NCKiser/Aioli/README.md

# Aioli
3x3 Macropad with 9 Encoders or MX Switches

GPL 2, Open Source, Please credit [Noah Kiser, KiserDesigns.com]
