NCKiser/Aioli/PCB/Aioli/Case v7.png

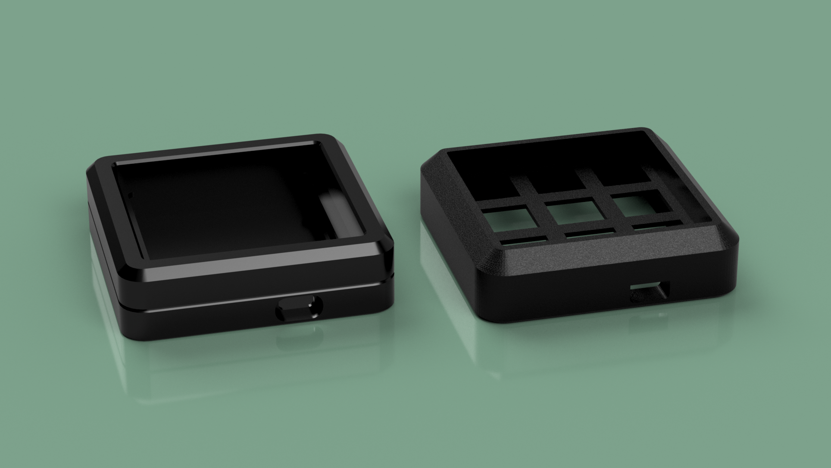
PCB/Aioli/Case v7.png
