NCKiser/Aioli/PCB/Aioli/Aioli.step

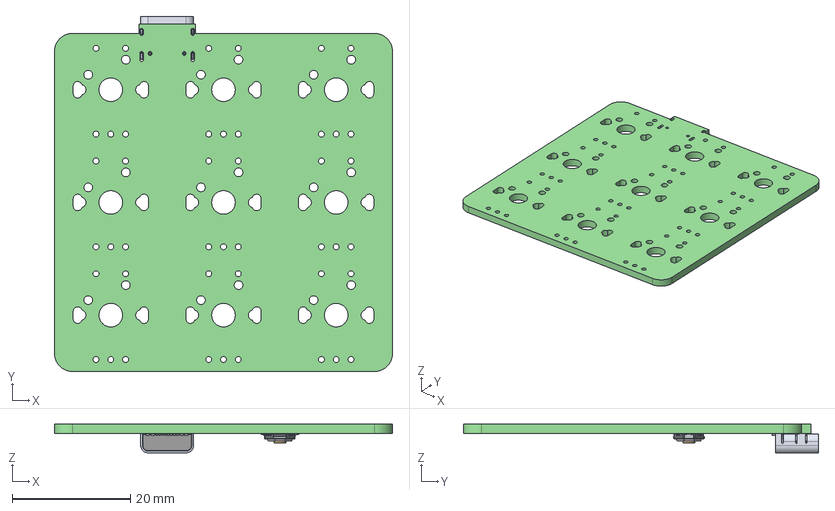
[picture p2: CAD file, 2022-03-29]
PCB/Aioli/Aioli.step
57.1 x 60.0 x 4.86 mm
Aioli PCB
