NCKiser/Aioli/Switch Plate.3mf

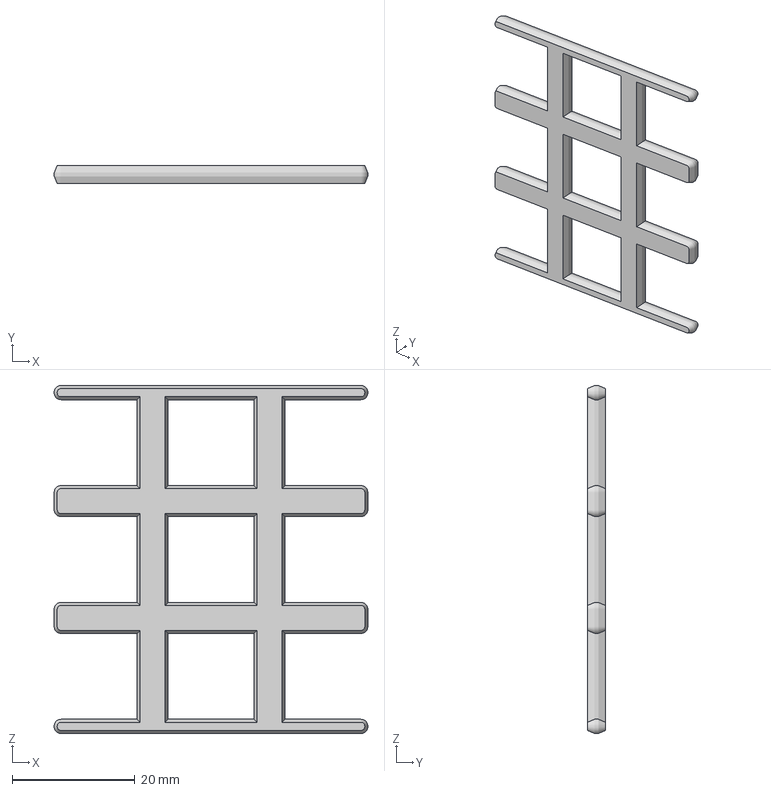
[picture p3: CAD file, 2022-03-29]
Switch Plate.3mf
51.1 x 3.00 x 56.8 mm
