NCKiser/Aioli/Case Bottom v3.3mf

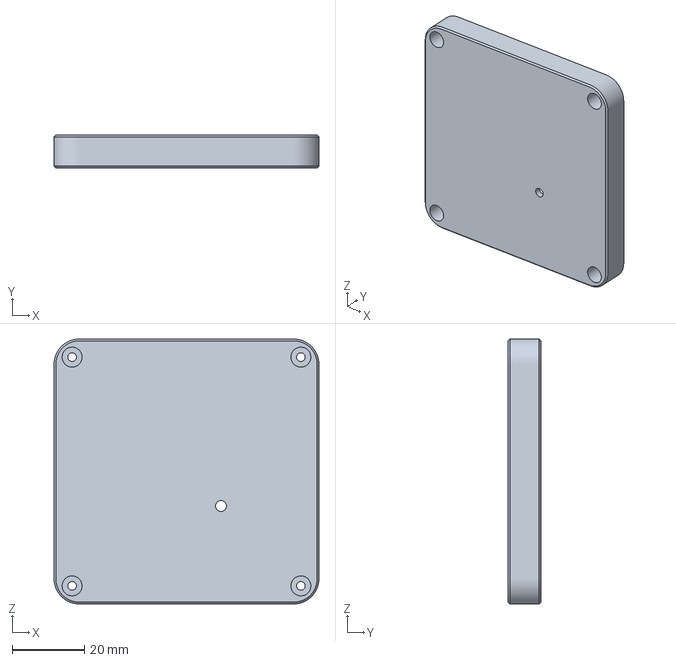
[picture p4: CAD file, 2022-03-29]
Case Bottom v3.3mf
73.2 x 9.10 x 73.2 mm
