NCKiser/Aioli/Case Top v3.3mf

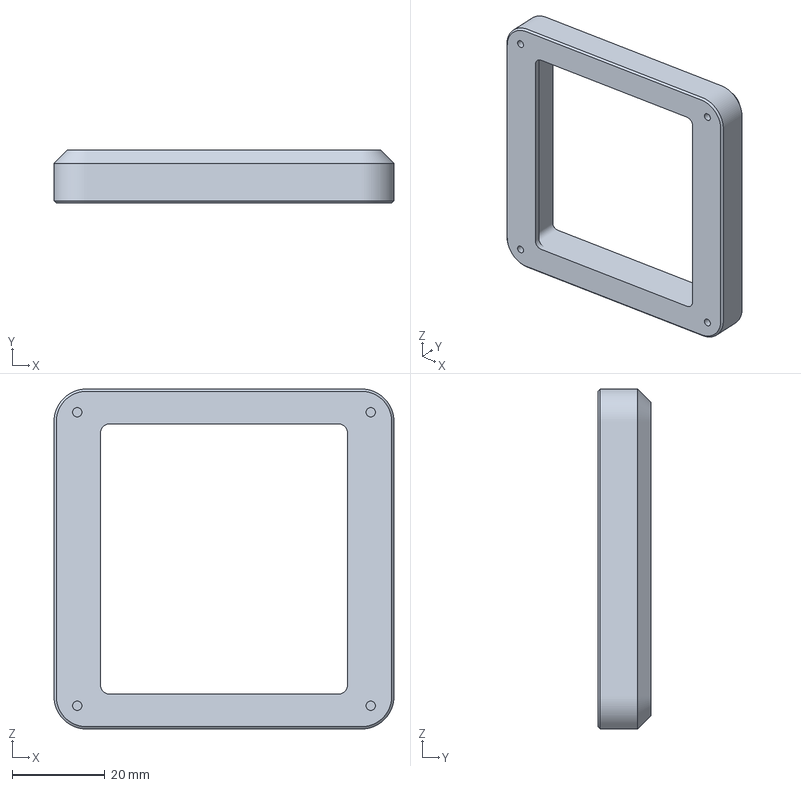
[picture p5: CAD file, 2022-03-29]
Case Top v3.3mf
73.2 x 11.5 x 73.2 mm
