NCKiser/Aioli/Aioli PCB.3mf

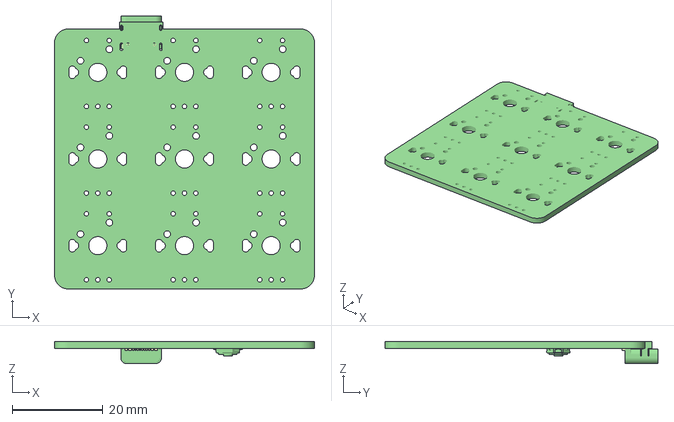
[picture p6: CAD file, 2022-03-29]
Aioli PCB.3mf
57.1 x 60.0 x 4.86 mm
