NCKiser/Aioli/Case Top v2.3mf

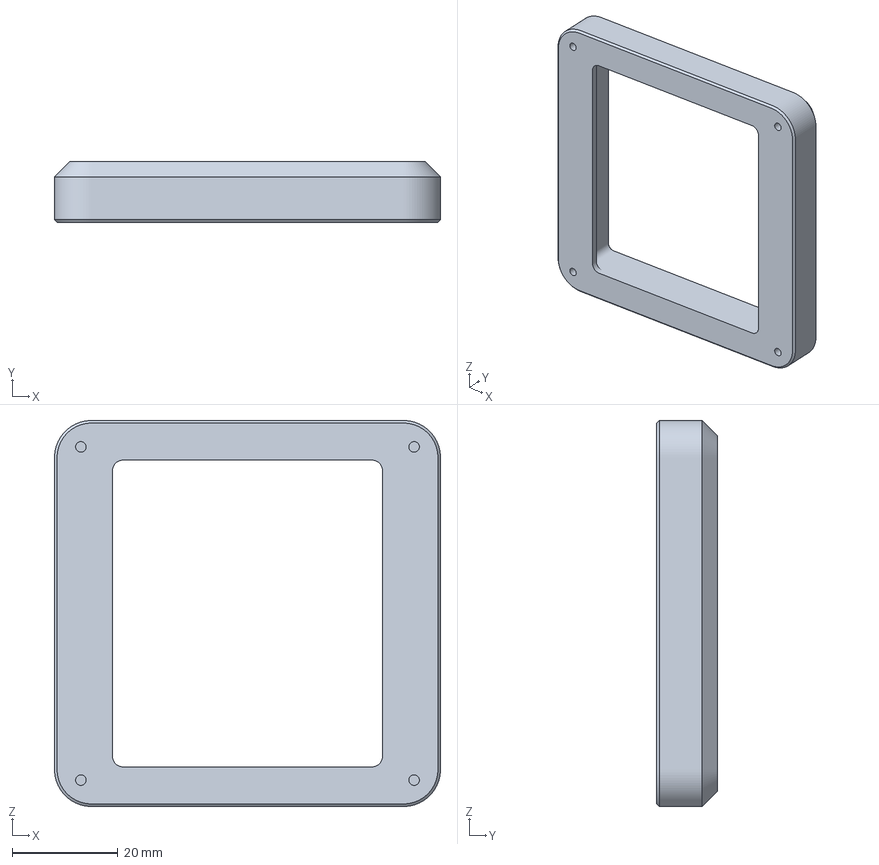
[picture p7: CAD file, 2022-03-29, an earlier design]
Case Top v2.3mf
73.2 x 11.5 x 73.2 mm
