NCKiser/Aioli/(list of files, cad)

Other CAD files:
Aioli Bottom.step
Aioli Top.step
Case Bottom v1.3mf
Case Bottom v2.3mf
Aioli Case.f3z
Case v18.f3z
