NCKiser/Aioli/Aioli Bottom.pdf

# 9.10 ⁰.5mm champer/deburr

73.15 | 52.15 | 58.15 | 73.15 Ø3.00

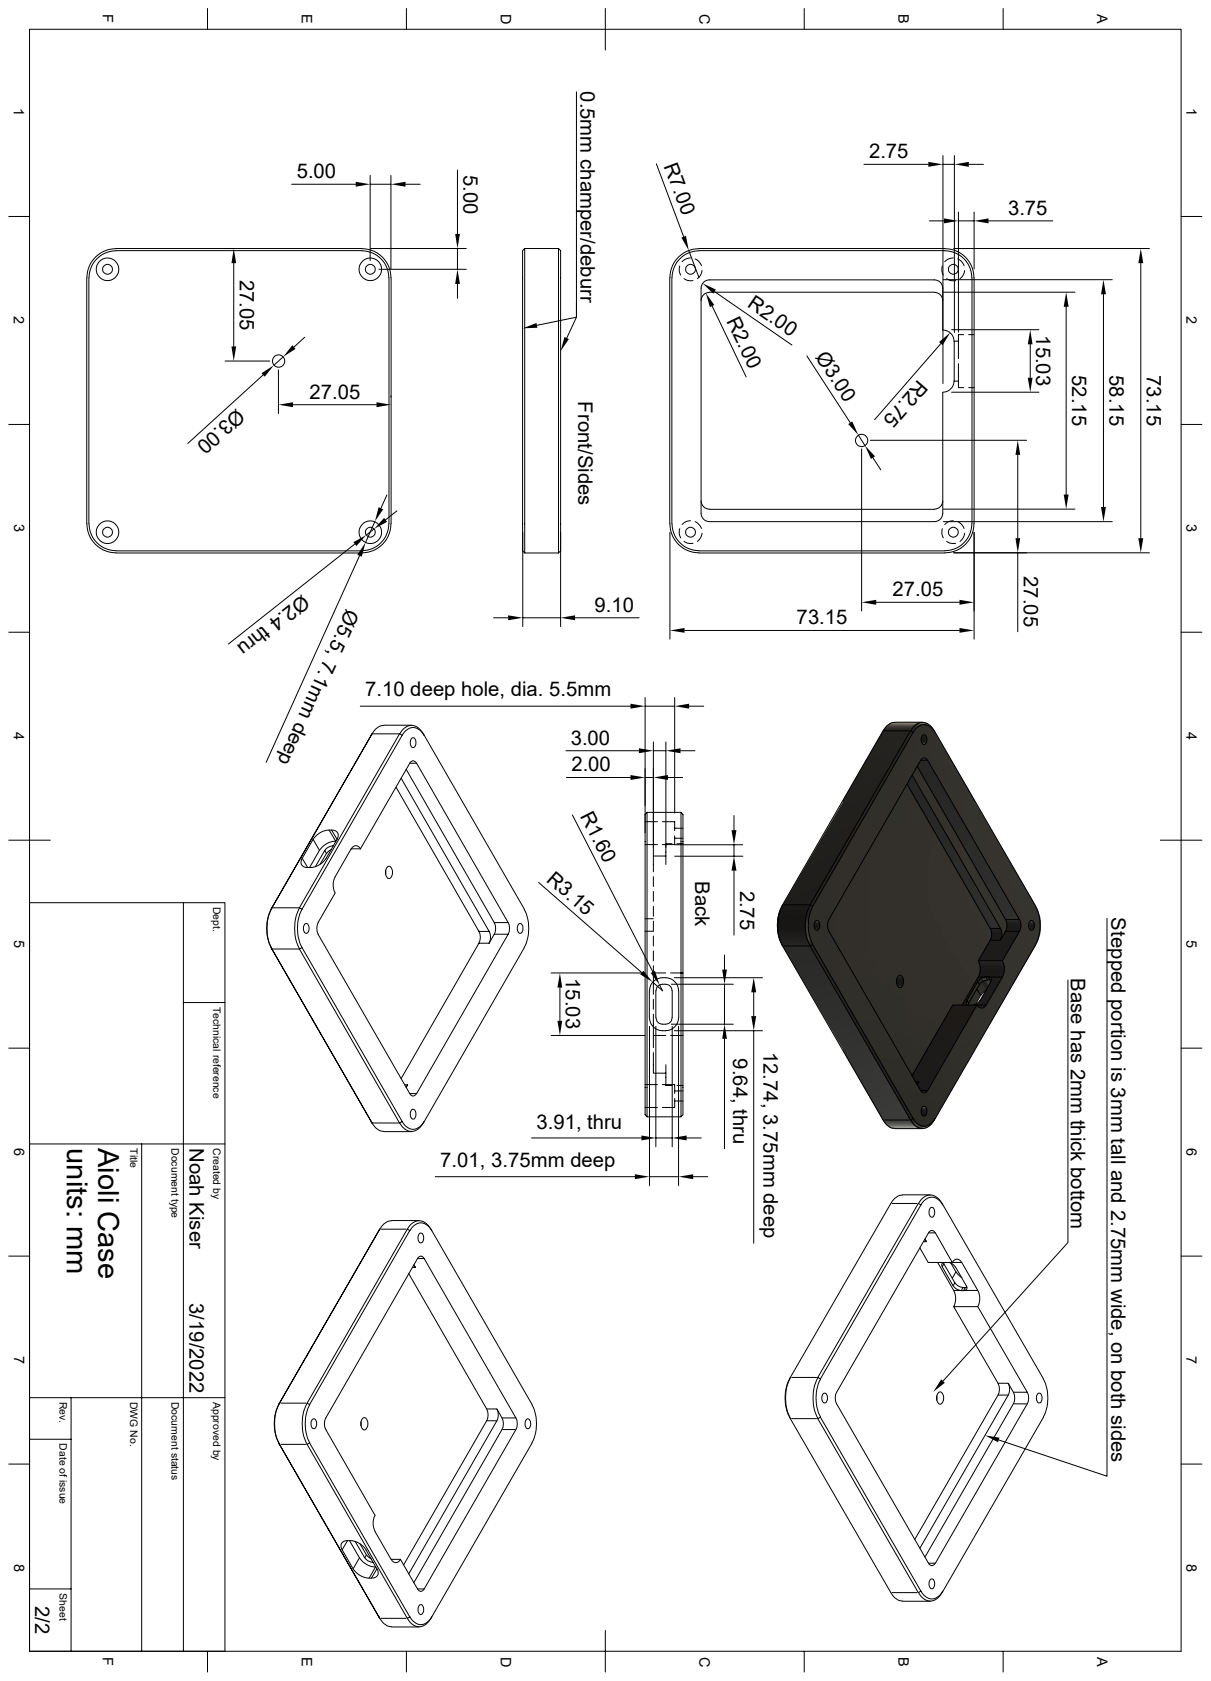
[picture p8: page 1]
2.75 15.03 R2.00 R2.00 R7.00 Front/Sides; Ø5.5, 7.1mm deep Ø2.4 thru; 7.10 deep hole, dia. 5.5mm 15.03; 12.74, 3.75mm deep 9.64, thru3.91, thru; 7.01, 3.75mm deep; Back; Stepped portion is 3mm tall and 2.75mm wide, on both sides Base has 2mm thick bottom

1 A 2 3 4 5 6 7 8 1 2 3 4 5 6 7 8 FEDCB FEDCBA Dept. Technical reference Created by Approved by Title DWG No. Document type Document status Rev. Date of issue Sheet 3/19/2022 2/2 units: mm Aioli Case Noah Kiser
