NCKiser/Aioli/Aioli Top.pdf

5.00 | 5.00 | R1.60 | R2.00 | R7.00 | R4 1.
2.9 2.9 0.5mm chamfer/deburr | 0.75mm inner chamfer/deburr

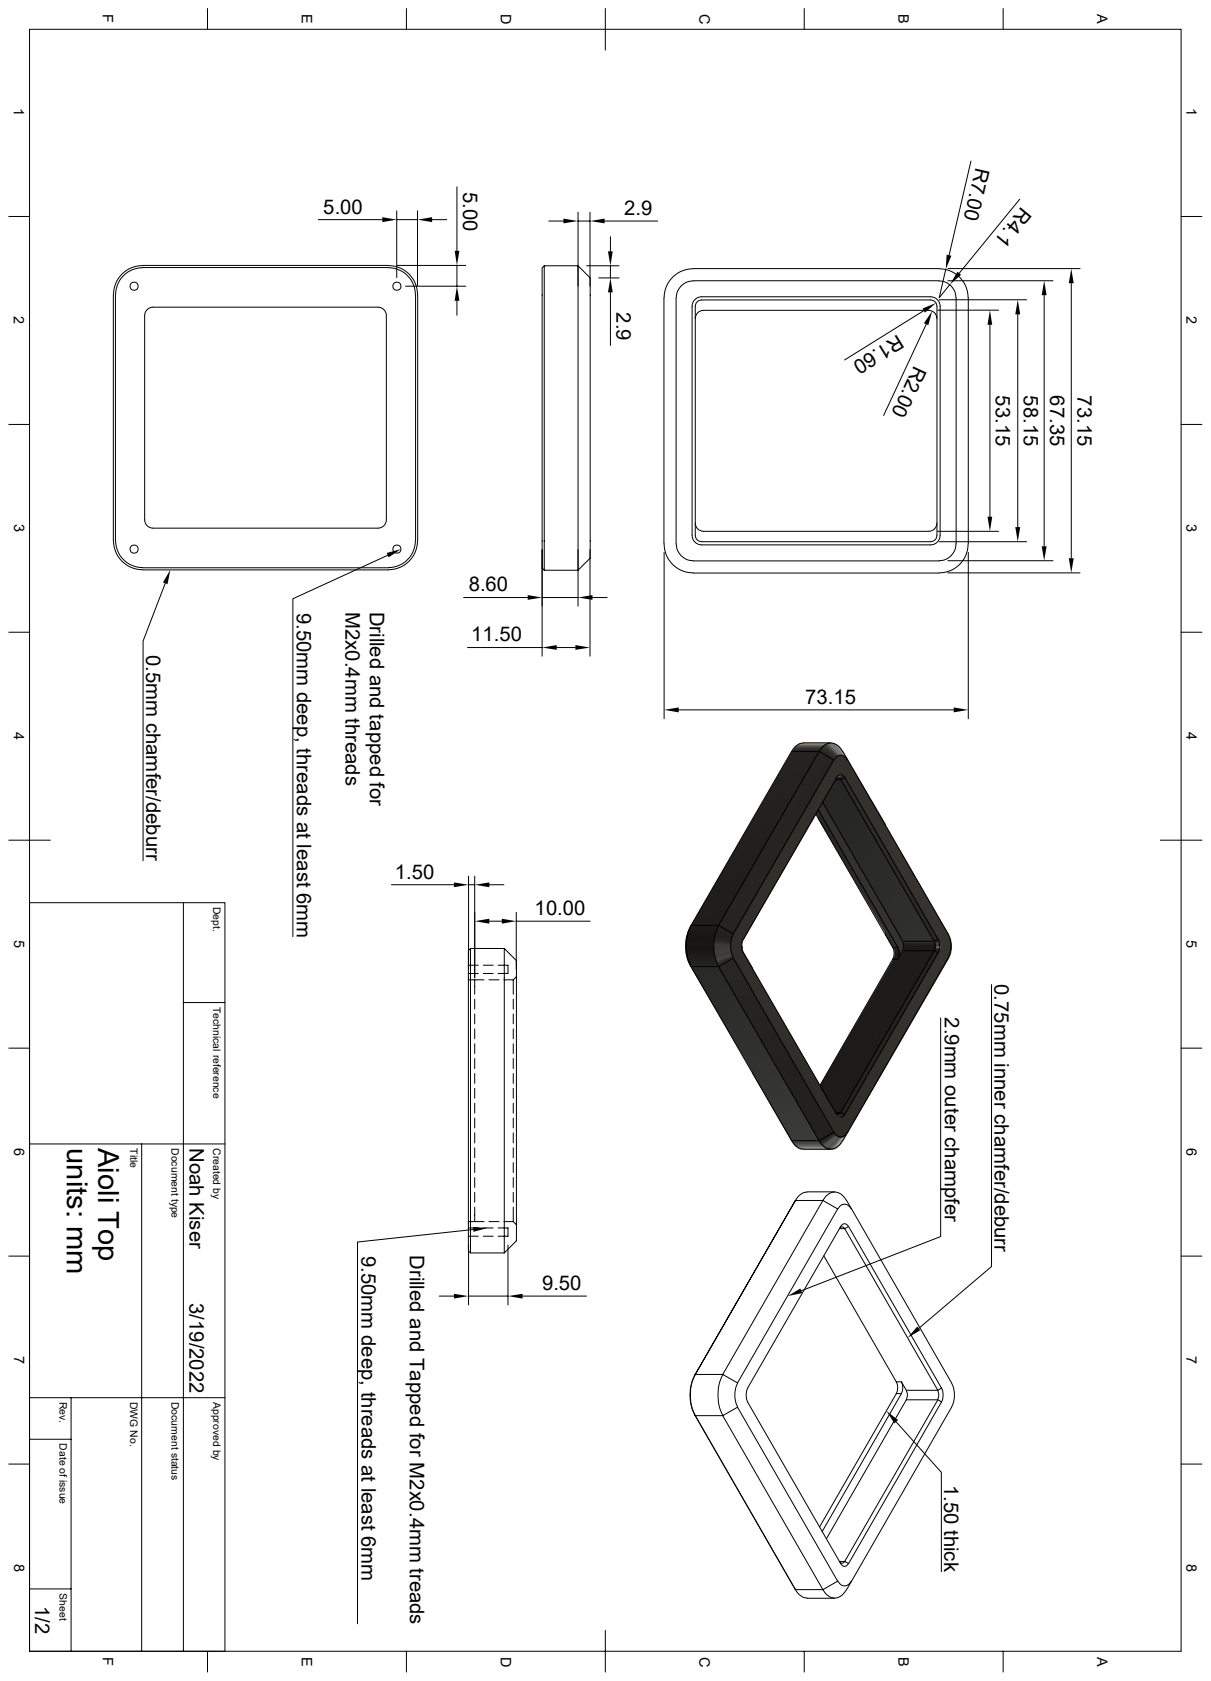
[picture p9: page 1]
9.50 ⁹.50mm deep, threads at least 6mm; Drilled and Tapped for M2x0.4mm treads 9.50mm deep, threads at least 6mm; M2x0.4mm threads Drilled and tapped for

1 A 2 3 4 5 6 7 8 1 2 3 4 5 6 7 8 FEDCB FEDCBA Dept. Technical reference Created by Approved by Title DWG No. Document type Document status Rev. Date of issue Sheet 3/19/2022 1/2 units: mm Aioli Top Noah Kiser

10.00 1.50 thick 2.9mm outer champfer
