NCKiser/Aioli/PCB/Aioli/Aioli.kicad_pcb

## KiCad design PCB/Aioli/Aioli.kicad_pcb (2022-03-29)

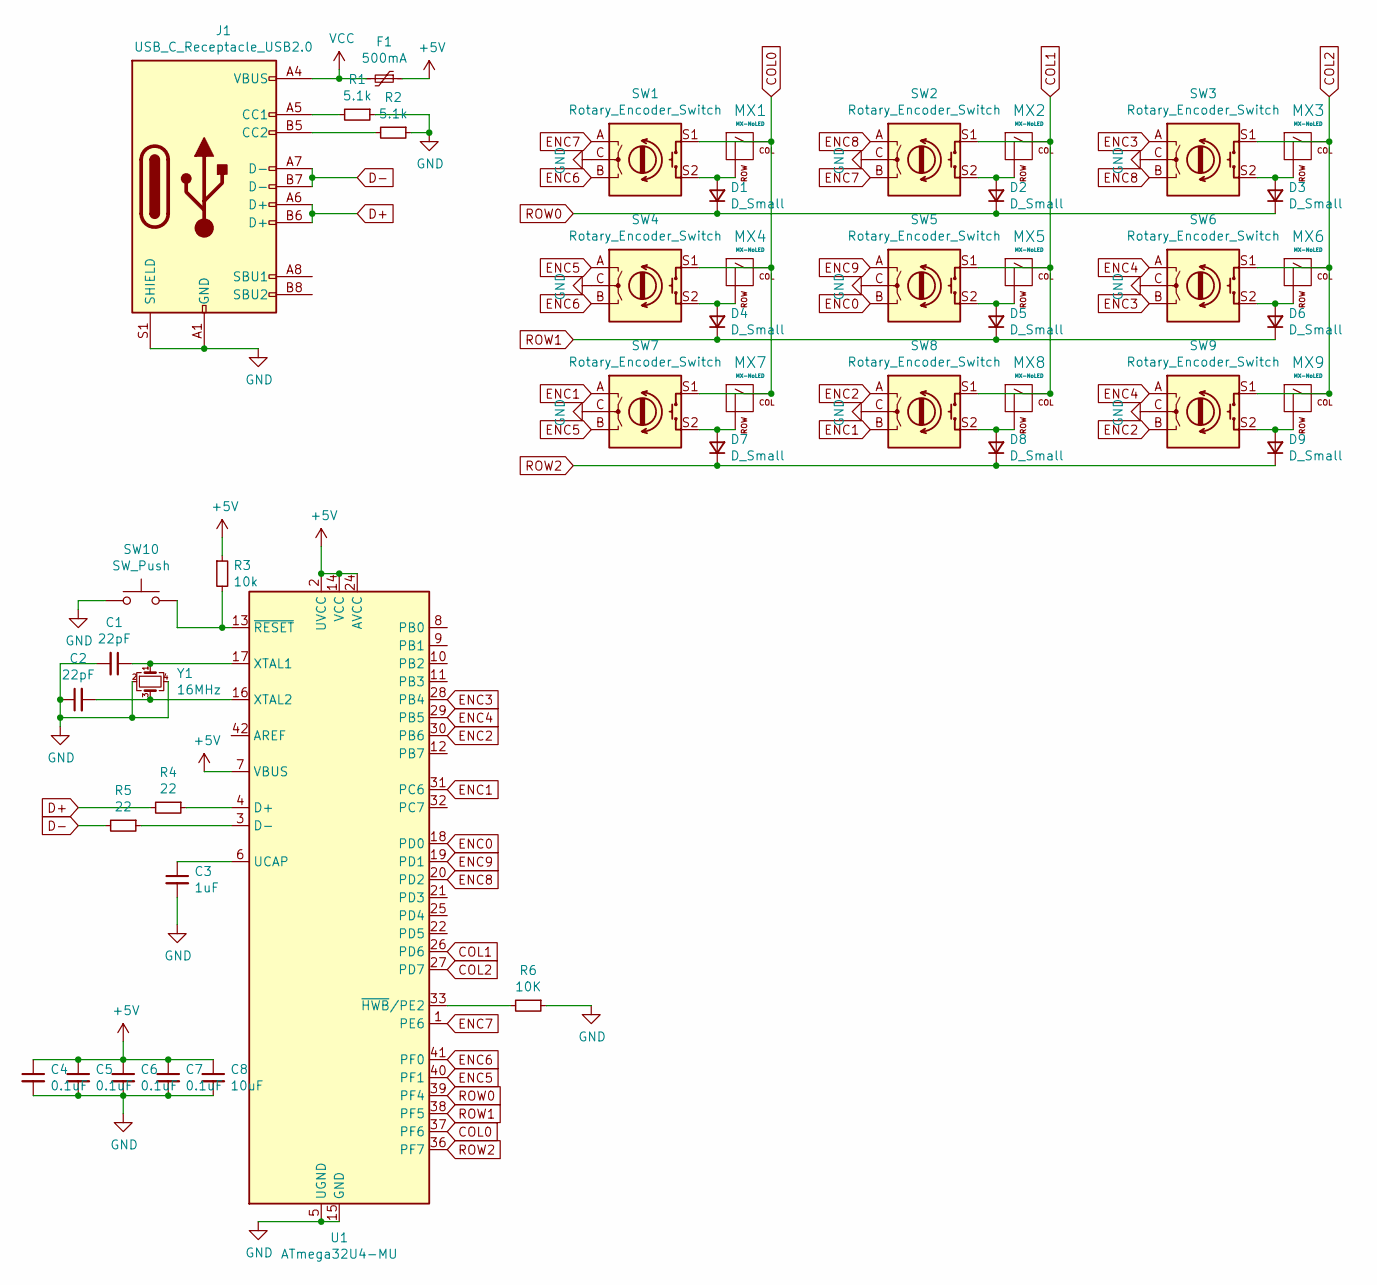
[picture p10: schematic Aioli.sch]

Parts:
C1, C2: 22pF; C_0603_1608Metric_Pad1.08x0.95mm_HandSolder
C3: 1uF; C_0603_1608Metric_Pad1.08x0.95mm_HandSolder
C4, C5, C6, C7: 0.1uF; C_0603_1608Metric_Pad1.08x0.95mm_HandSolder
C8: 10uF; C_0603_1608Metric_Pad1.08x0.95mm_HandSolder
D1, D2, D3, D4, D5, D6, D7, D8, D9: D_Small; D_SOD-123
F1: 500mA; Fuse_1206_3216Metric
J1: USB_C_Receptacle_USB2.0; USB_C_Receptacle_HRO_TYPE-C-31-M-12
MX1, MX2, MX3, MX4, MX5, MX6, MX7, MX8, MX9: MX-NoLED; MXOnly-1U-NoLED
R1, R2: 5.1k; R_0603_1608Metric_Pad0.98x0.95mm_HandSolder
R3: 10k; R_0603_1608Metric_Pad0.98x0.95mm_HandSolder
R4, R5: 22; R_0603_1608Metric_Pad0.98x0.95mm_HandSolder
R6: 10K; R_0603_1608Metric_Pad0.98x0.95mm_HandSolder
SW1, SW2, SW3, SW4, SW5, SW6, SW7, SW8, SW9: Rotary_Encoder_Switch; RotaryEncoder_Alps_EC11E-Switch_Vertical_H20mm
SW10: SW_Push; SKQG-1155865
U1: ATmega32U4-MU; QFN-44-1EP_7x7mm_P0.5mm_EP5.2x5.2mm
Y1: 16MHz; Crystal_SMD_3225-4Pin_3.2x2.5mm

Connections:
+5V: C4.1, C5.1, C6.1, C7.1, C8.1, F1.1, R3.1, U1.2 (UVCC), U1.7 (VBUS), U1.14 (VCC), U1.24 (AVCC), U1.34 (VCC), U1.44 (AVCC)
COL0: MX1.1 (COL), MX4.1 (COL), MX7.1 (COL), SW1.S1, SW4.S1, SW7.S1, U1.37 (PF6)
COL1: MX2.1 (COL), MX5.1 (COL), MX8.1 (COL), SW2.S1, SW5.S1, SW8.S1, U1.26 (PD6)
COL2: MX3.1 (COL), MX6.1 (COL), MX9.1 (COL), SW3.S1, SW6.S1, SW9.S1, U1.27 (PD7)
D+: J1.A6 (D+), J1.B6 (D+), R4.2
D-: J1.A7 (D-), J1.B7 (D-), R5.2
ENC0: SW5.B, U1.18 (PD0)
ENC1: SW7.A, SW8.B, U1.31 (PC6)
ENC2: SW8.A, SW9.B, U1.30 (PB6)
ENC3: SW3.A, SW6.B, U1.28 (PB4)
ENC4: SW6.A, SW9.A, U1.29 (PB5)
ENC5: SW4.A, SW7.B, U1.40 (PF1)
ENC6: SW1.B, SW4.B, U1.41 (PF0)
ENC7: SW1.A, SW2.B, U1.1 (PE6)
ENC8: SW2.A, SW3.B, U1.20 (PD2)
ENC9: SW5.A, U1.19 (PD1)
GND: C1.2, C2.1, C3.2, C4.2, C5.2, C6.2, C7.2, C8.2, J1.A1 (GND), J1.A12 (GND), J1.B1 (GND), J1.B12 (GND), J1.S1 (SHIELD), R1.1, R2.1, R6.1, SW1.C, SW2.C, SW3.C, SW4.C, SW5.C, SW6.C, SW7.C, SW8.C, SW9.C, SW10.1, U1.5 (UGND), U1.15 (GND), U1.23 (GND), U1.35 (GND), U1.43 (GND), U1.45 (GND), Y1.2, Y1.4
unnamed: C1.1, U1.17 (XTAL1), Y1.1
unnamed: C2.2, U1.16 (XTAL2), Y1.3
unnamed: C3.1, U1.6 (UCAP)
unnamed: D1.2 (A), MX1.2 (ROW), SW1.S2
unnamed: D2.2 (A), MX2.2 (ROW), SW2.S2
unnamed: D3.2 (A), MX3.2 (ROW), SW3.S2
unnamed: D4.2 (A), MX4.2 (ROW), SW4.S2
unnamed: D5.2 (A), MX5.2 (ROW), SW5.S2
unnamed: D6.2 (A), MX6.2 (ROW), SW6.S2
unnamed: D7.2 (A), MX7.2 (ROW), SW7.S2
unnamed: D8.2 (A), MX8.2 (ROW), SW8.S2
unnamed: D9.2 (A), MX9.2 (ROW), SW9.S2
unnamed: J1.A5 (CC1), R1.2
unnamed: J1.B5 (CC2), R2.2
unnamed: R3.2, SW10.2, U1.13 (~RESET)
unnamed: R4.1, U1.4 (D+)
unnamed: R5.1, U1.3 (D-)
unnamed: R6.2, U1.33 (~HWB~/PE2)
ROW0: D1.1 (K), D2.1 (K), D3.1 (K), U1.39 (PF4)
ROW1: D4.1 (K), D5.1 (K), D6.1 (K), U1.38 (PF5)
ROW2: D7.1 (K), D8.1 (K), D9.1 (K), U1.36 (PF7)
VCC: F1.2, J1.A4 (VBUS), J1.A9 (VBUS), J1.B4 (VBUS), J1.B9 (VBUS)

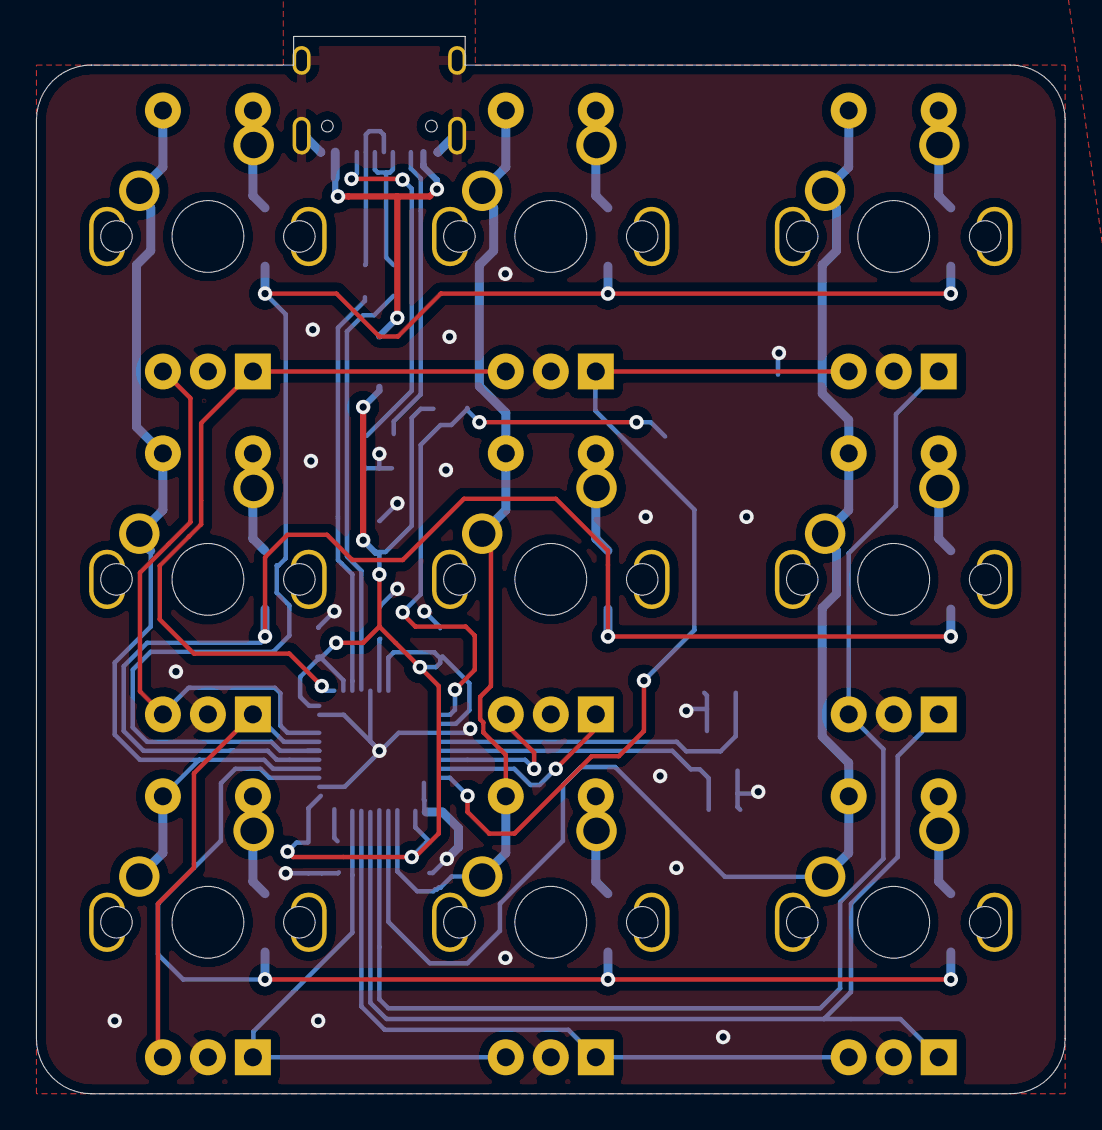
[picture p11: board Aioli.kicad_pcb from above]

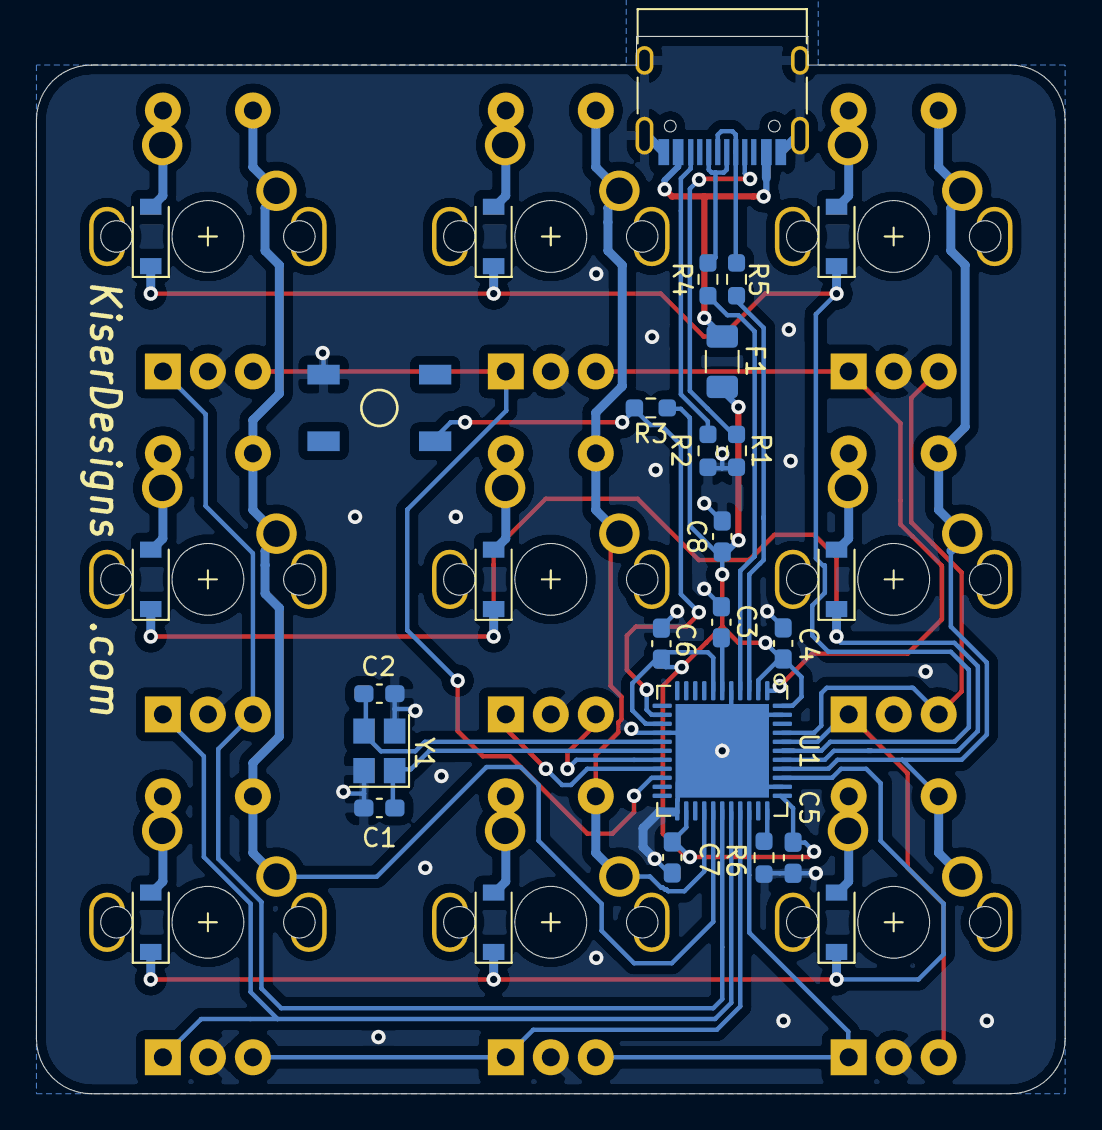
[picture p12: board Aioli.kicad_pcb from below]

Board: 2 copper layers, 57.1 x 58.7 mm, 46 parts (37 on the bottom side), 39 nets.
