NCKiser/Aioli/(commit log)

2022-02-03 Created PCB
    [Aioli.kicad_pcb, Aioli.sch]
2022-02-06 Subtle Changes
    [Aioli.kicad_pcb]
2022-03-29 Generated Gerbers, CAD files
    [Aioli Bottom.step, Aioli Case.f3z, Aioli PCB.3mf, Aioli Top.step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]
